bsidestlv/bsidestlv-2026-badge/software/references/alice-reference4.png

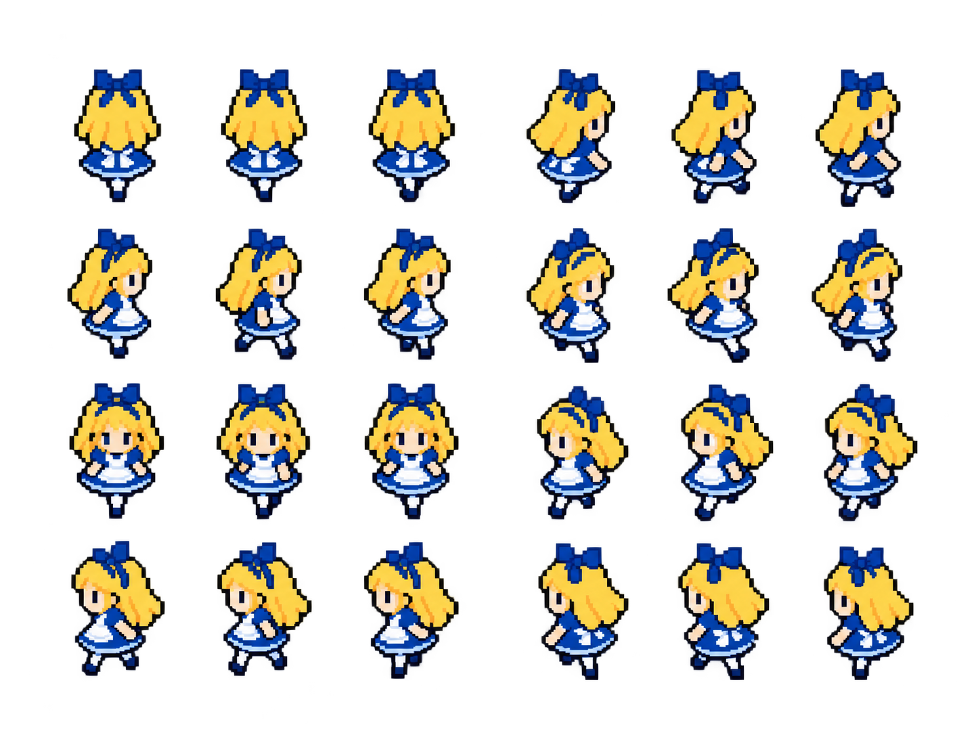
software/references/alice-reference4.png
