bsidestlv/bsidestlv-2026-badge/hardware/badge/PhoneController.step

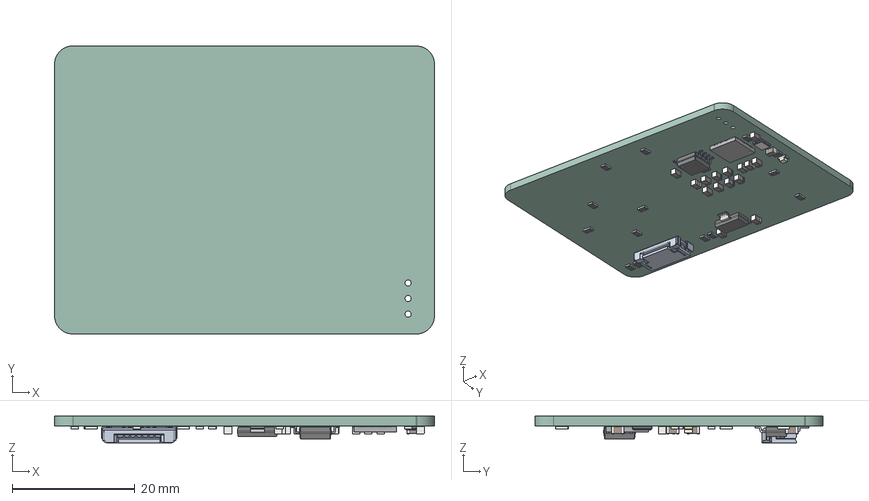
[picture p13: CAD file, 2026-09-22]
hardware/badge/PhoneController.step
62.0 x 47.0 x 4.35 mm
R_0805_2012Metric x 15
C_0805_2012Metric x 16
Crystal_SMD_Abracon_ABM8G-4Pin_3.2x2.5mm
SOT_223
QFN_56_1EP_7x7mm_P04mm_EP32x32mm
LED_0805_2012Metric
SOIC_8_5275x5275mm_P127mm
PhoneController_PCB
