bsidestlv/bsidestlv-2026-badge/(list of files, drawings)

Other design files:
hardware/badge/freerouting.dsn
