bsidestlv/bsidestlv-2026-badge/hardware/soldering-kit/BSidesTLV26TinyBadge.kicad_pcb

## KiCad design hardware/soldering-kit/BSidesTLV26TinyBadge.kicad_pcb (2026-09-22)

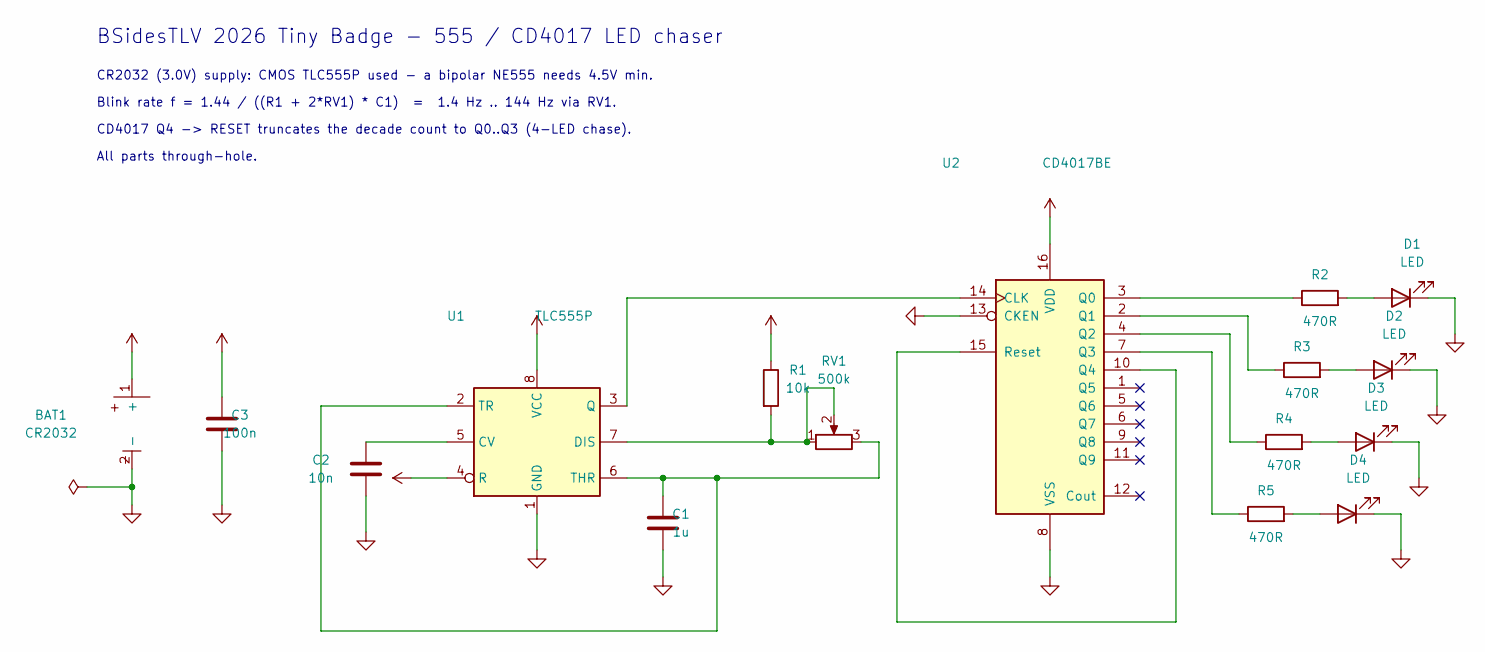
[picture p17: schematic BSidesTLV26TinyBadge.kicad_sch]

Parts:
BAT1: CR2032; BS-02-A1AJ010; MPN C5239862
C1: 1u; C_Disc_D5.0mm_W2.5mm_P5.00mm
C2: 10n; C_Disc_D5.0mm_W2.5mm_P5.00mm
C3: 100n; C_Disc_D5.0mm_W2.5mm_P5.00mm
D1, D2, D3, D4: LED; LED_D4.0mm
R1: 10k; R_Axial_DIN0207_L6.3mm_D2.5mm_P10.16mm_Horizontal
R2, R3, R4, R5: 470R; R_Axial_DIN0207_L6.3mm_D2.5mm_P10.16mm_Horizontal
RV1: 500k; Potentiometer_Bourns_3296W_Vertical
U1: TLC555P; DIP-8_W7.62mm
U2: CD4017BE; DIP-16_W7.62mm

Connections:
GND: BAT1.2 (-), C1.2, C2.2, C3.2, D1.1 (K), D2.1 (K), D3.1 (K), D4.1 (K), U1.1 (GND), U2.8 (VSS), U2.13 (CKEN)
unnamed: D1.2 (A), R2.2
unnamed: D2.2 (A), R3.2
unnamed: D3.2 (A), R4.2
unnamed: D4.2 (A), R5.2
unnamed: C2.1, U1.5 (CV)
unnamed: R1.2, RV1.1, RV1.2, U1.7 (DIS)
unnamed: U1.3 (Q), U2.14 (CLK)
unnamed: C1.1, RV1.3, U1.2 (TR), U1.6 (THR)
unnamed: R2.1, U2.3 (Q0)
unnamed: R3.1, U2.2 (Q1)
unnamed: R4.1, U2.4 (Q2)
unnamed: R5.1, U2.7 (Q3)
unnamed: U2.10 (Q4), U2.15 (Reset)
VCC: BAT1.1 (+), C3.1, R1.1, U1.4 (R), U1.8 (VCC), U2.16 (VDD)

Notes on the sheet:
CR2032 (3.0V) supply: CMOS TLC555P used - a bipolar NE555 needs 4.5V min.
BSidesTLV 2026 Tiny Badge - 555 / CD4017 LED chaser
All parts through-hole.
CD4017 Q4 -> RESET truncates the decade count to Q0..Q3 (4-LED chase).
Blink rate f = 1.44 / ((R1 + 2*RV1) * C1) = 1.4 Hz .. 144 Hz via RV1.

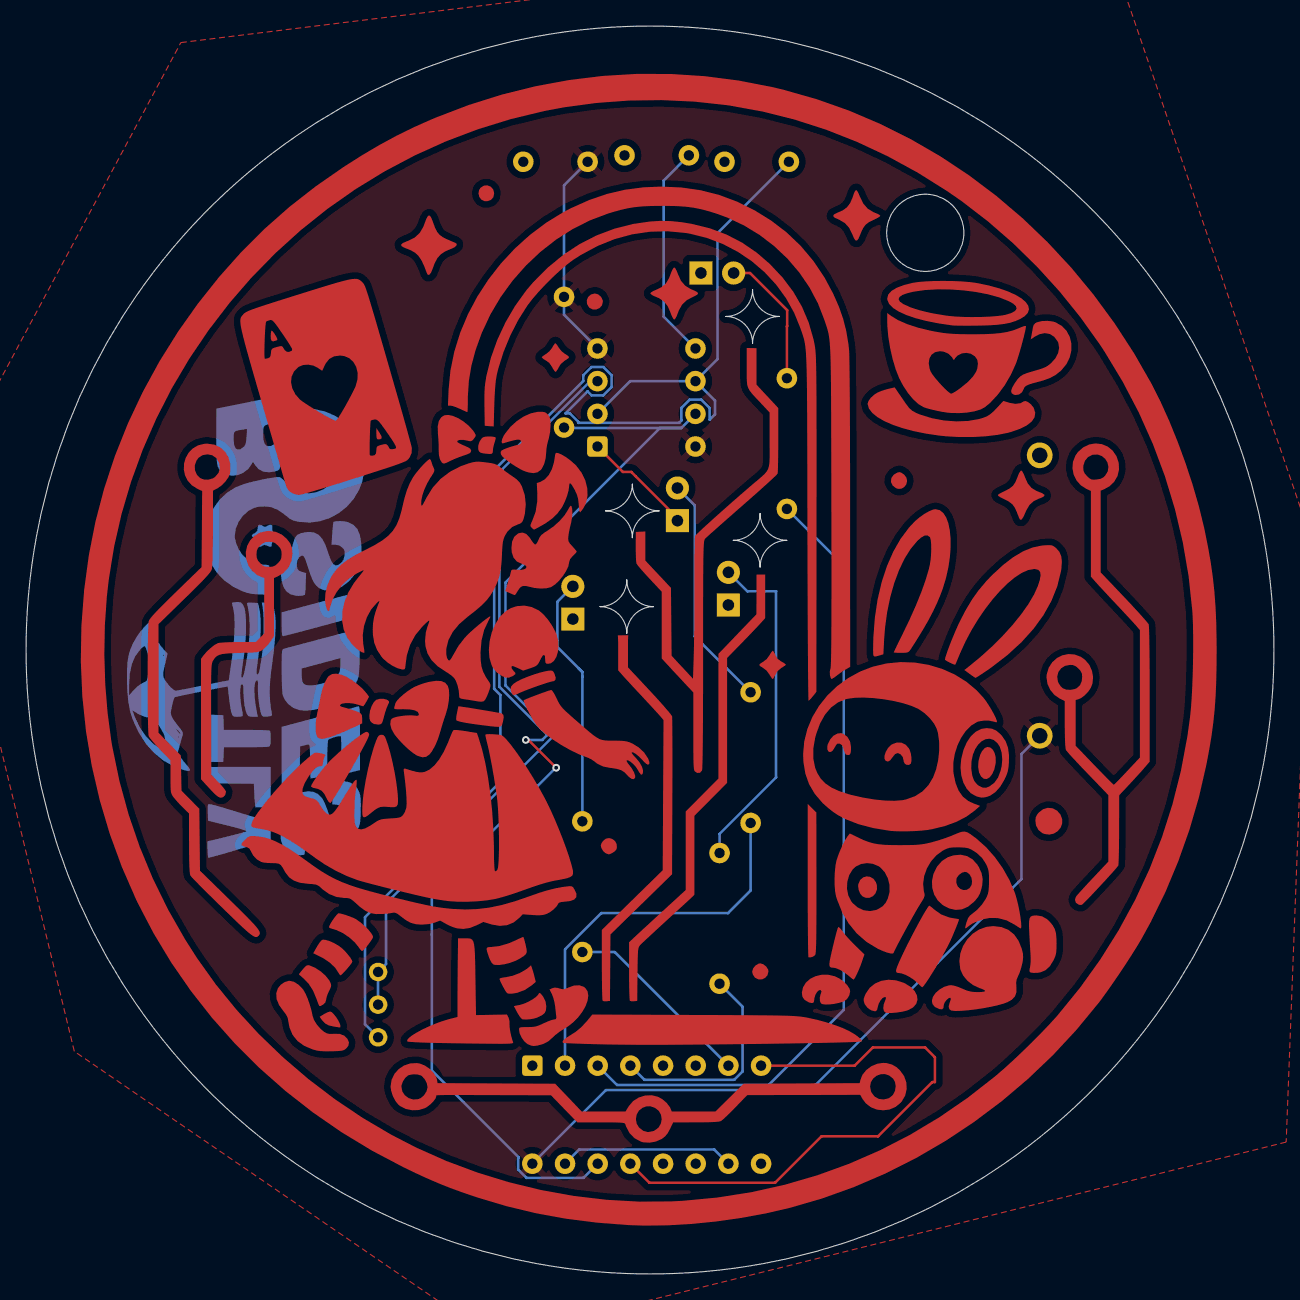
[picture p18: board BSidesTLV26TinyBadge.kicad_pcb from above]

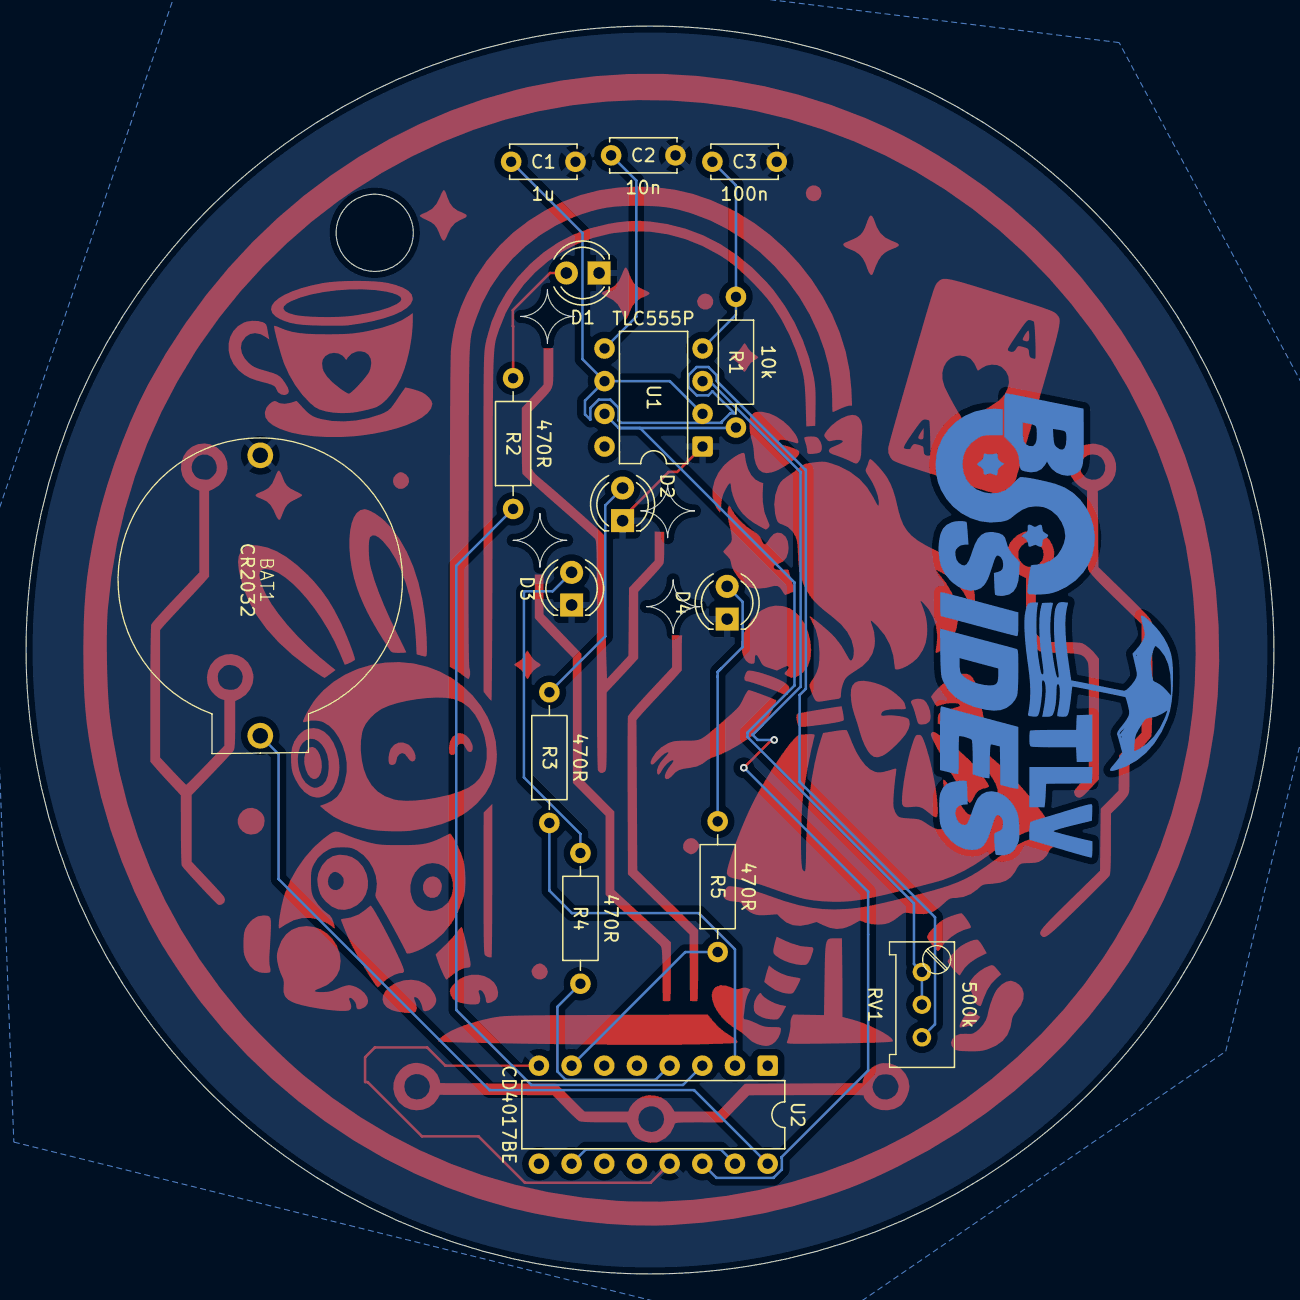
[picture p19: board BSidesTLV26TinyBadge.kicad_pcb from below]

Board: 2 copper layers, 97.0 x 97.0 mm, 16 parts (16 on the bottom side), 15 nets.
