bsidestlv/bsidestlv-2026-badge/(commit log)

2026-09-22 Organize the badge repo: hardware/ + software/, licences, docs
    The tree was two loose drops - a KiCad dumping ground under hw/ and a nested
    git repo for the challenge. Both are now one repo with two halves that match
    how the badge is actually used: boards in hardware/, the online challenge that
    runs on them in software/.
    Hardware, three KiCad 9 projects, one directory each, doubled folder nesting
    flattened:
    hardware/badge/ the PCB-art badge, with its source graphics
    hardware/soldering-kit/ the TLC555 + CD4017 workshop kit
    hardware/controller/ JoyFon v0.4, the RP2040 controller
    Loose gerbers moved into controller/gerbers/. Removed ~40MB of KiCad rolling
    archives (*-backups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
    [BSidesTLV26Badge.kicad_pcb, BSidesTLV26Badge.kicad_sch, BSidesTLV26TinyBadge.kicad_pcb, BSidesTLV26TinyBadge.kicad_sch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]
2026-09-22 Drop the PCB-art board; the RP2040 controller is the badge
    hardware/ is two projects now, not three. The art-only board is gone and
    PhoneController - "JoyFon v0.4" - moves into hardware/badge/, since the thing
    the challenge is played on is the badge.
    The rename had landed as hardware/badge/controller/ rather than
    hardware/badge/: the old badge directory still held KiCad's ignored state
    (fp-info-cache, *.kicad_prl, a rolling backup), so mv nested the project
    inside it instead of replacing it. Flattened, and the stale art-board .kicad_prl
    and fp-info-cache removed.
    Docs follow: root README and hardware/README drop the third board, point every
    path at hardware/badge/, and note that the KiCad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
    [BSidesTLV26Badge.kicad_pcb, BSidesTLV26Badge.kicad_sch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]
2026-09-22 Split software/ into a publishable site/ and the workshop around it
    The page was already static - relative paths throughout, python -m http.server
    only because ES modules refuse file:// - but "the site" and "the toolchain"
    shared one directory, so there was nothing a Pages deploy could point at.
    software/site/ index.html, styles.css, src/, stages/, assets/
    software/tools/ slicing and generation, writes into site/assets/
    software/references/ the 15MB of source sheets
    software/legacy/ the generated-sprite pass the page stopped loading
    software/docs/ design doc
    site/ is now exactly what ships, 3.8MB of it. The legacy sprite code moved out
    of it wholesale -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
2026-09-22 Add the badge firmware, copied from ~/pico/joyfon as software/controller
    The board had no firmware in the repo, so nobody could build what the badge
    actually runs. Copied in from the upstream project - which is left in place and
    unmodified - as software/controller/, with joyfon renamed to controller
    throughout the build.
    The rename only touches CMake: project(), the executable target and the four
    commands that name it, so the build now produces build/controller.uf2. It does
    not touch USB identity - the descriptors report Sony's VID/PID 054C:09CC and
    the strings "Sony Interactive Entertainment" / "Wireless Controller", which is
    the whole point of the design. iOS only binds controllers it rec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
    [PhoneControllerCaseV0.3 - BackPlate.stl, PhoneControllerCaseV0.3 - BtnA.stl, PhoneControllerCaseV0.3 - BtnB.stl, PhoneControllerCaseV0.3 - BtnSL.stl, PhoneControllerCaseV0.3 - BtnSR.stl, PhoneControllerCaseV0.3 - BtnX.stl, PhoneControllerCaseV0.3 - BtnY.stl, PhoneControllerCaseV0.3 - ControllerBody.stl]
2026-09-22 Drop joyfon's hardware; keep only the firmware it contributed
    This repo's board is a variation of joyfon's, so joyfon's own hardware files
    were a second, diverging copy of things that already live here - or that never
    applied. Removed: hardware/usb-board/ (the PhoneControllerUSB breakout),
    software/controller/stl/ (15 enclosure meshes for joyfon's case) and
    software/controller/images/ (case renders and joyfon PCB shots).
    software/controller/ is now firmware and nothing else: CMakeLists.txt,
    pico_sdk_import.cmake, src/ and a README. Still builds - 41KB controller.uf2,
    unchanged.
    The CC2 caveat stays, because it is about this badge and it is worse than
    joyfon's note said. Checked against har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
    [PhoneControllerCaseV0.3 - BackPlate.stl, PhoneControllerCaseV0.3 - BtnA.stl, PhoneControllerCaseV0.3 - BtnB.stl, PhoneControllerCaseV0.3 - BtnSL.stl, PhoneControllerCaseV0.3 - BtnSR.stl, PhoneControllerCaseV0.3 - BtnX.stl, PhoneControllerCaseV0.3 - BtnY.stl, PhoneControllerCaseV0.3 - ControllerBody.stl]
2026-09-22 Revert the CC-pin analysis; leave hardware commentary to the author
    I had rewritten the USB-C note from my own reading of the netlist and added a
    "Known issue" section to hardware/README.md. Both are out. The original note is
    restored verbatim from the upstream project, and hardware/README.md carries no
    claim about CC pins.
    No hardware design file was ever modified by any commit in this branch - the
    history shows only adds from moving files into the repo and the two deletions
    that were asked for. hardware/badge/'s .kicad_pcb, .kicad_sch and .kicad_pro are
    still byte-identical to the copy at ~/kicad/PhoneController/.
    The restored note refers to hw/usb/PhoneControllerUSB.kicad_sch, which is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
2026-09-22 Serve the site from the repo root
    GitHub Pages serves a repository root or a /docs folder; software/site/ was
    neither, so publishing needed the workflow to reach into a subdirectory. Moved
    index.html, styles.css, src/, stages/, assets/ and .nojekyll up to the root,
    where a branch-based Pages source would also find them. package.json and
    serve.sh came up with them, since both exist to serve and check the site.
    software/ is now strictly the things that produce the site and are never
    served: tools/, references/, legacy/, docs/ and the controller firmware.
    Tools repointed for the extra level - the Python slicers write ../../assets,
    both verifiers import ../../src and resolve their stage argume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
